gemivnet/IRL2FA/docs/images/pcb/pcb-iso.png

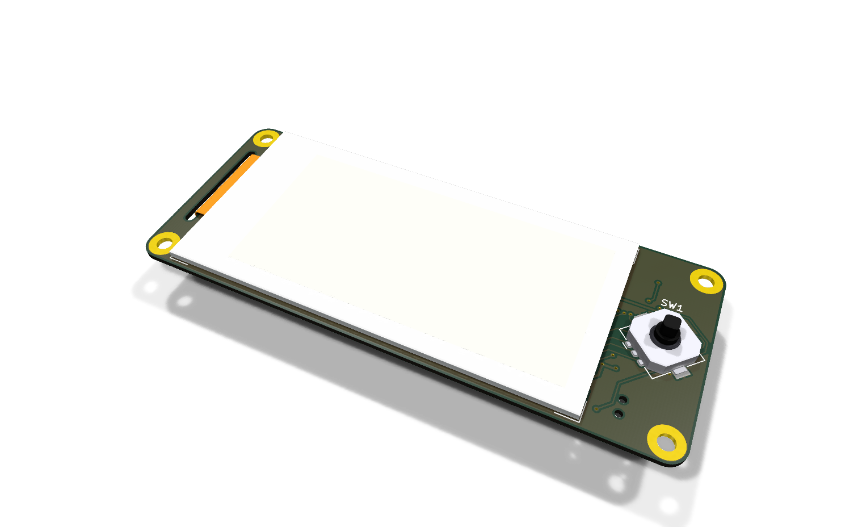
docs/images/pcb/pcb-iso.png
