gemivnet/IRL2FA/docs/images/screens/contacts.png

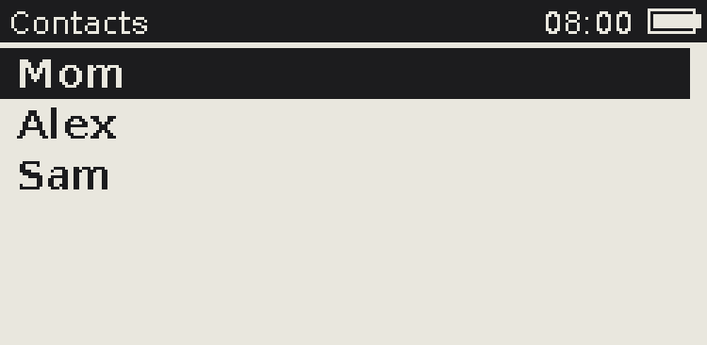
docs/images/screens/contacts.png
