gemivnet/IRL2FA/docs/images/sim/sim-battery.png

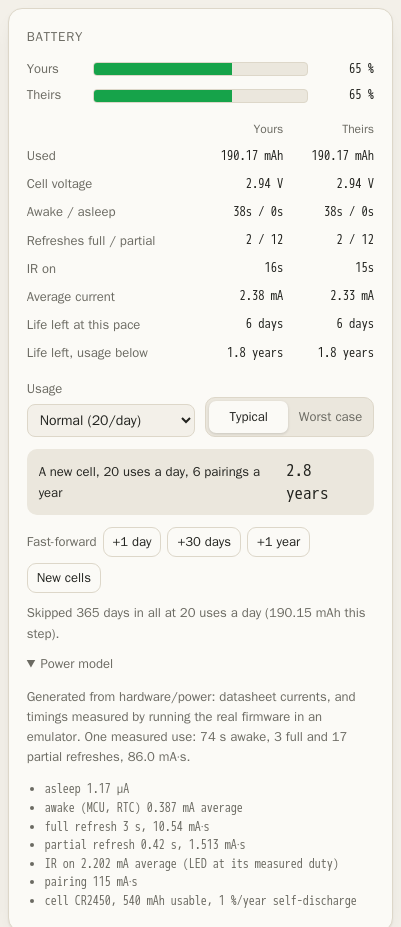
docs/images/sim/sim-battery.png
