gemivnet/IRL2FA/docs/images/sim/sim-mobile.png

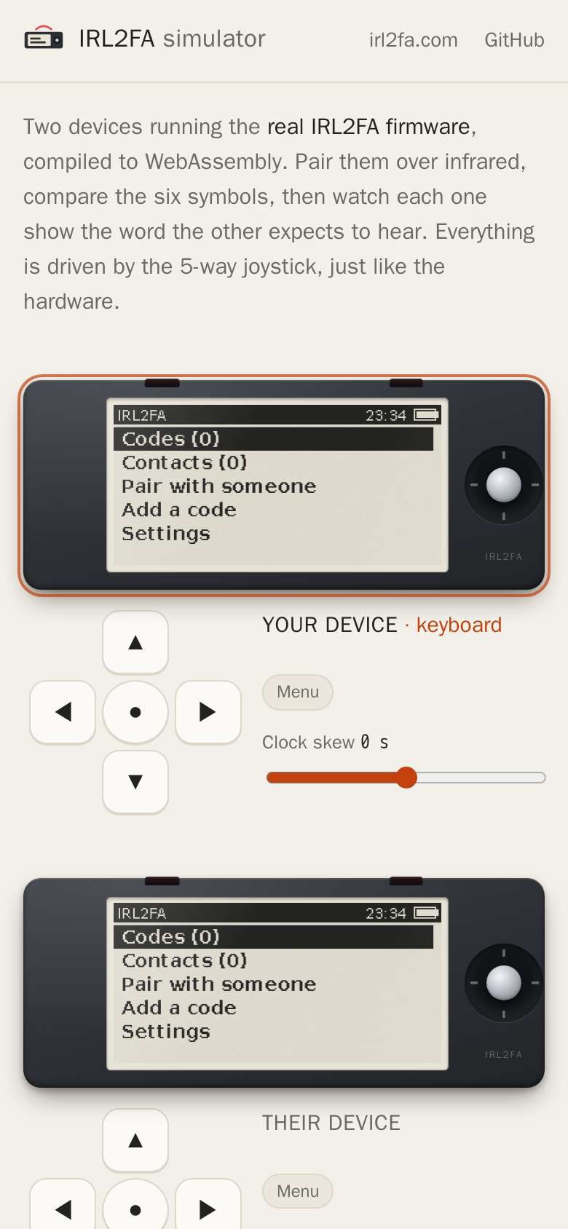
docs/images/sim/sim-mobile.png
