gemivnet/IRL2FA/docs/images/sim/sim-range.png

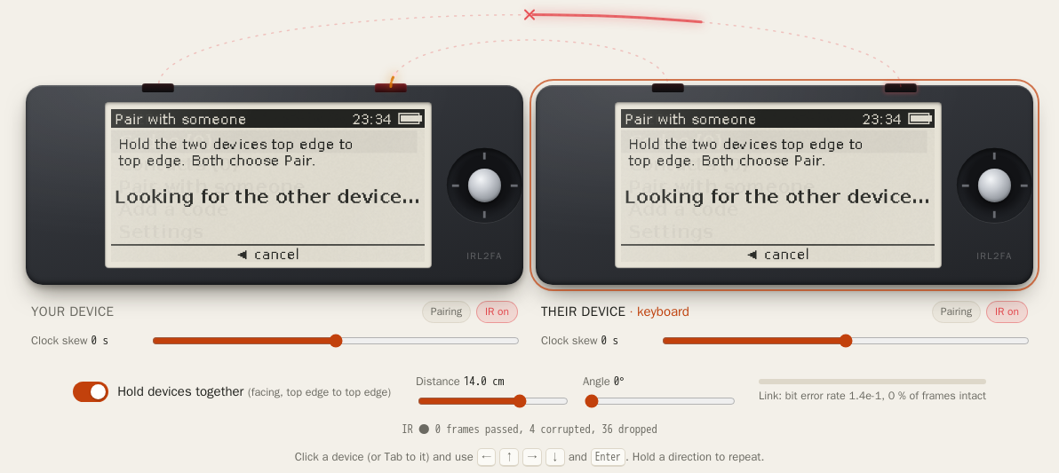
docs/images/sim/sim-range.png
