gemivnet/IRL2FA/docs/images/sim/sim-words.png

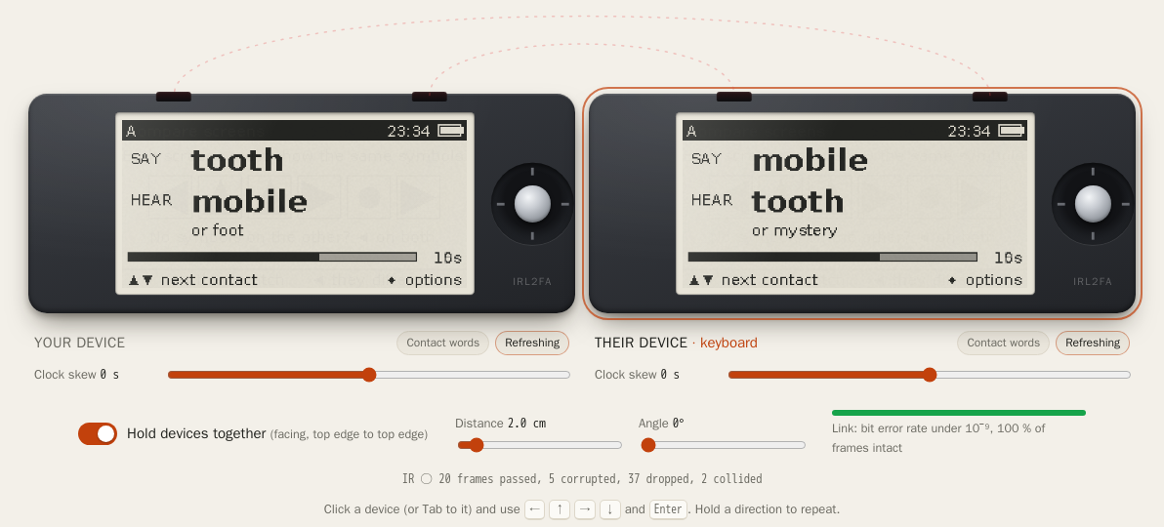
docs/images/sim/sim-words.png
