gemivnet/IRL2FA/hardware/fab/irl2fa-bom-jlcpcb.csv

Comment | Designator | Footprint | LCSC Part #
CR2450 | BT1 | BatteryHolder_MYOUNG_MY-2450-01_CR2450 | C964845
47u | C1,C2 | C_0805_2012Metric | C16780
100n | C3,C4,C8,C9 | C_0402_1005Metric | C1525
4.7u | C5 | C_0603_1608Metric | C19666
1u | C6 | C_0402_1005Metric | C52923
10n | C7 | C_0402_1005Metric | C15195
4.7u | C10,C11 | C_0805_2012Metric | C1779
1u | C12,C13,C14,C15,C16,C17,C18,C19 | C_0603_1608Metric | C15849
MBR0530 | D1,D2,D3 | D_SOD-123 | C77336
VSMB2948SL | D4 | LED_Vishay_VSMB2948SL_SideView | C6604342
FH34SRJ-24S | J1 | Hirose_FH34SRJ-24S-0.5SH_1x24-1MP_P0.50mm_Horizontal | C324726
47u | L1 | L_APV_ANR3015 | C7427088
AO3401A | Q1,Q2 | SOT-23 | C15127
NX3008NBK | Q3 | SOT-23 | C179399
AO3400A | Q4 | SOT-23 | C20917
VEMT2023SLX01 | Q5 | PhotoTransistor_Vishay_VEMT2023SLX01_SideView | C2843576
10k | R1,R2,R10 | R_0402_1005Metric | C25744
4.7k | R3,R4 | R_0402_1005Metric | C25900
100k | R5,R9 | R_0402_1005Metric | C25741
1M | R6 | R_0402_1005Metric | C26083
2.2 | R7 | R_0402_1005Metric | C25101
68 | R8 | R_0402_1005Metric | C25131
SKRHABE010 | SW1 | SW_Nav_Alps_SKRHABE010 | C139794
STM32U083KCU6 | U1 | UFQFPN-32-1EP_5x5mm_P0.5mm_EP3.5x3.5mm | C22459164
RV-3032-C7 | U2 | MicroCrystal_C7_SON-8_1.5x3.2mm_P0.9mm | C5127802
