gemivnet/IRL2FA/case/3mf/irl2fa-all.3mf

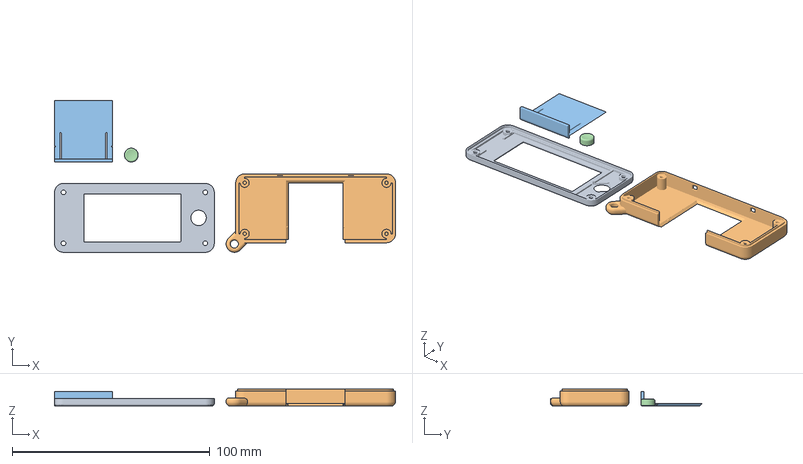
[picture p36: CAD file, 2026-10-29]
case/3mf/irl2fa-all.3mf
172.6 x 76.8 x 8.40 mm
irl2fa-front
irl2fa-back
irl2fa-door
irl2fa-cap
