gemivnet/IRL2FA/case/stl/irl2fa-front.stl

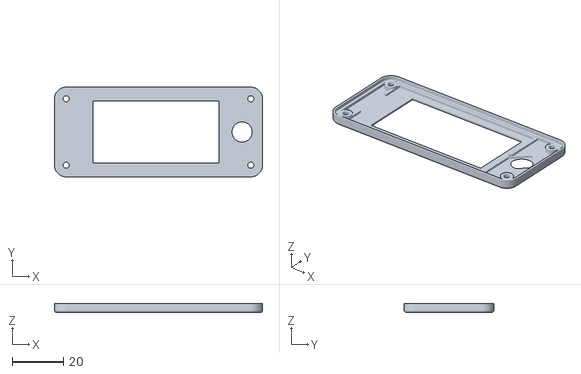
[picture p37: CAD file, 2026-10-29]
case/stl/irl2fa-front.stl
80.9 x 34.9 x 3.60
