gemivnet/IRL2FA/hardware/fab/irl2fa.step

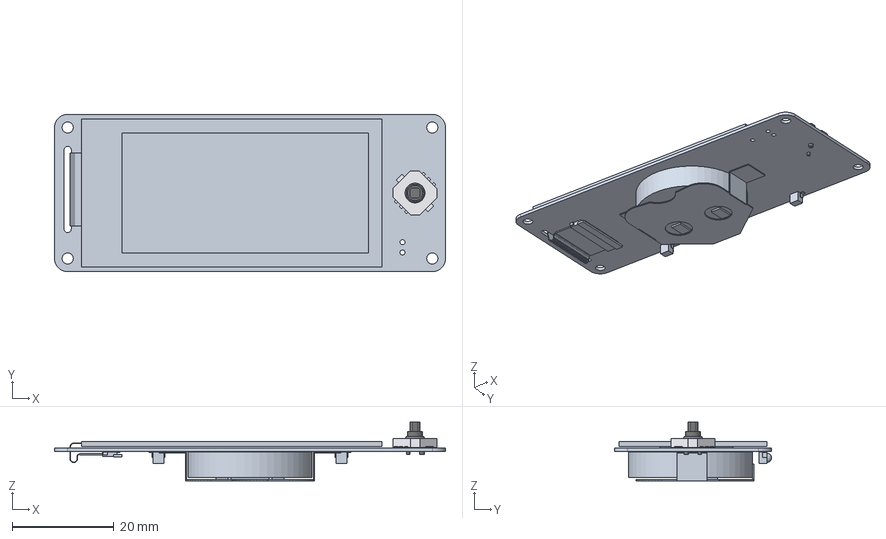
[picture p38: CAD file, 2026-10-30]
hardware/fab/irl2fa.step
77.0 x 31.0 x 11.6 mm
SW_Nav_Alps_SKRHABE010_0
SW_Nav_Alps_SKRHABE010_1
SW_Nav_Alps_SKRHABE010_2
SW_Nav_Alps_SKRHABE010_3
SW_Nav_Alps_SKRHABE010_4
SW_Nav_Alps_SKRHABE010_5
SW_Nav_Alps_SKRHABE010_6
SW_Nav_Alps_SKRHABE010_7
SW_Nav_Alps_SKRHABE010_8
SW_Nav_Alps_SKRHABE010_9
SW_Nav_Alps_SKRHABE010_10
SW_Nav_Alps_SKRHABE010_11
SW_Nav_Alps_SKRHABE010_12
SW_Nav_Alps_SKRHABE010_13
EPD_GoodDisplay_GDEY0213B74_Outline_0
EPD_GoodDisplay_GDEY0213B74_Outline_1
EPD_GoodDisplay_GDEY0213B74_Outline_2
Hirose_FH34SRJ-24S-0.5SH_1x24-1MP_P0.50mm_Horizontal_0
Hirose_FH34SRJ-24S-0.5SH_1x24-1MP_P0.50mm_Horizontal_1
Hirose_FH34SRJ-24S-0.5SH_1x24-1MP_P0.50mm_Horizontal_2
Hirose_FH34SRJ-24S-0.5SH_1x24-1MP_P0.50mm_Horizontal_3
Hirose_FH34SRJ-24S-0.5SH_1x24-1MP_P0.50mm_Horizontal_4
Hirose_FH34SRJ-24S-0.5SH_1x24-1MP_P0.50mm_Horizontal_5
Hirose_FH34SRJ-24S-0.5SH_1x24-1MP_P0.50mm_Horizontal_6
Hirose_FH34SRJ-24S-0.5SH_1x24-1MP_P0.50mm_Horizontal_7
Hirose_FH34SRJ-24S-0.5SH_1x24-1MP_P0.50mm_Horizontal_8
Hirose_FH34SRJ-24S-0.5SH_1x24-1MP_P0.50mm_Horizontal_9
Hirose_FH34SRJ-24S-0.5SH_1x24-1MP_P0.50mm_Horizontal_10
Hirose_FH34SRJ-24S-0.5SH_1x24-1MP_P0.50mm_Horizontal_11
Hirose_FH34SRJ-24S-0.5SH_1x24-1MP_P0.50mm_Horizontal_12
Hirose_FH34SRJ-24S-0.5SH_1x24-1MP_P0.50mm_Horizontal_13
Hirose_FH34SRJ-24S-0.5SH_1x24-1MP_P0.50mm_Horizontal_14
Hirose_FH34SRJ-24S-0.5SH_1x24-1MP_P0.50mm_Horizontal_15
Hirose_FH34SRJ-24S-0.5SH_1x24-1MP_P0.50mm_Horizontal_16
Hirose_FH34SRJ-24S-0.5SH_1x24-1MP_P0.50mm_Horizontal_17
Hirose_FH34SRJ-24S-0.5SH_1x24-1MP_P0.50mm_Horizontal_18
Hirose_FH34SRJ-24S-0.5SH_1x24-1MP_P0.50mm_Horizontal_19
Hirose_FH34SRJ-24S-0.5SH_1x24-1MP_P0.50mm_Horizontal_20
Hirose_FH34SRJ-24S-0.5SH_1x24-1MP_P0.50mm_Horizontal_21
Hirose_FH34SRJ-24S-0.5SH_1x24-1MP_P0.50mm_Horizontal_22
Hirose_FH34SRJ-24S-0.5SH_1x24-1MP_P0.50mm_Horizontal_23
Hirose_FH34SRJ-24S-0.5SH_1x24-1MP_P0.50mm_Horizontal_24
Hirose_FH34SRJ-24S-0.5SH_1x24-1MP_P0.50mm_Horizontal_25
Hirose_FH34SRJ-24S-0.5SH_1x24-1MP_P0.50mm_Horizontal_26
Hirose_FH34SRJ-24S-0.5SH_1x24-1MP_P0.50mm_Horizontal_27
PhotoTransistor_Vishay_VEMT2023SLX01_SideView_0
PhotoTransistor_Vishay_VEMT2023SLX01_SideView_1
PhotoTransistor_Vishay_VEMT2023SLX01_SideView_2
PhotoTransistor_Vishay_VEMT2023SLX01_SideView_3
PhotoTransistor_Vishay_VEMT2023SLX01_SideView_4
PhotoTransistor_Vishay_VEMT2023SLX01_SideView_5
BatteryHolder_MYOUNG_MY-2450-01_CR2450_0
BatteryHolder_MYOUNG_MY-2450-01_CR2450_1
BatteryHolder_MYOUNG_MY-2450-01_CR2450_2
BatteryHolder_MYOUNG_MY-2450-01_CR2450_3
BatteryHolder_MYOUNG_MY-2450-01_CR2450_4
BatteryHolder_MYOUNG_MY-2450-01_CR2450_5
BatteryHolder_MYOUNG_MY-2450-01_CR2450_6
BatteryHolder_MYOUNG_MY-2450-01_CR2450_7
BatteryHolder_MYOUNG_MY-2450-01_CR2450_8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
