gemivnet/IRL2FA/case/stl/irl2fa-door.stl

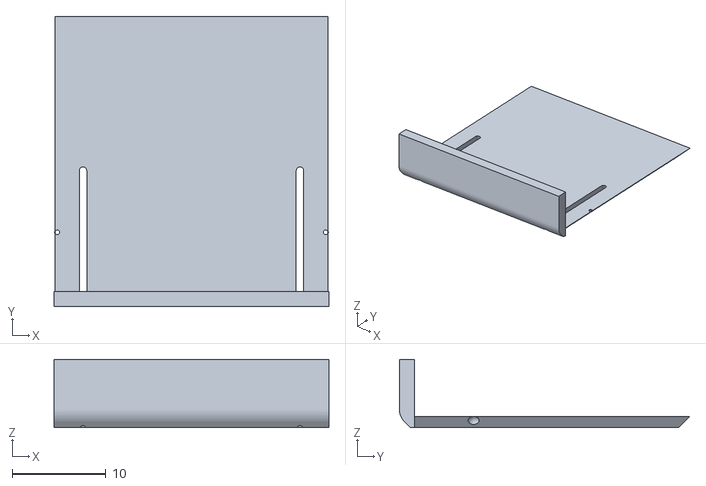
[picture p39: CAD file, 2026-10-29]
case/stl/irl2fa-door.stl
29.4 x 31.0 x 7.30
