gemivnet/IRL2FA/case/stl/irl2fa-cap.stl

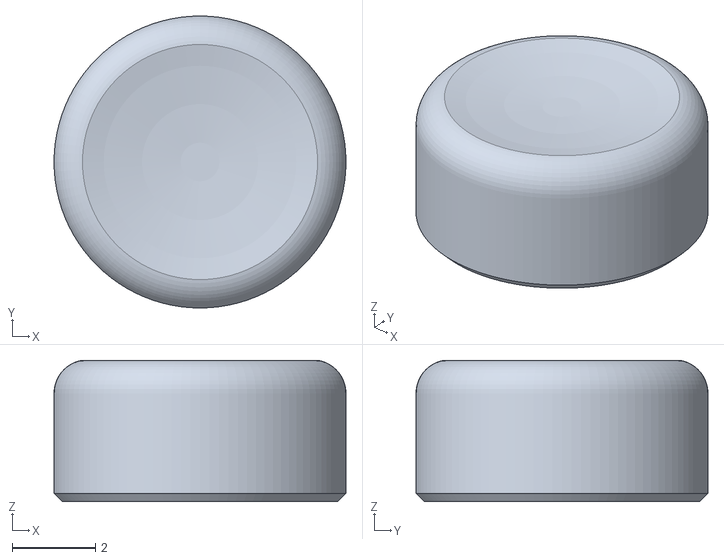
[picture p40: CAD file, 2026-10-29]
case/stl/irl2fa-cap.stl
7.00 x 7.00 x 3.39
