gemivnet/IRL2FA/case/stl/irl2fa-back.stl

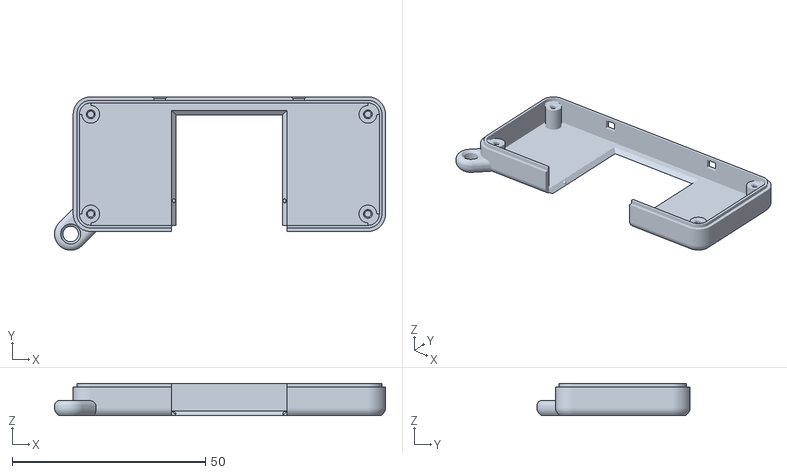
[picture p41: CAD file, 2026-10-29]
case/stl/irl2fa-back.stl
85.7 x 39.7 x 8.40
