gemivnet/IRL2FA/case/board_dims.scad

// GENERATED FILE - DO NOT EDIT.
// Source: hardware/board.yaml  (regenerate: python case/tools/gen_dims.py)
// Units: mm. Board coordinates: origin at the board's top-left corner seen
// from the FRONT, x right, y down (see board.yaml).
// SPDX-License-Identifier: CC-BY-SA-4.0

board_width = 77;
board_height = 31;
board_thickness = 0.8;
board_corner_radius = 2.6;
board_mounting_holes = [[2.6, 2.6], [74.4, 2.6], [2.6, 28.4], [74.4, 28.4]];  // each [x, y]
board_mounting_hole_drill = 2.2;
display_part = "GDEY0213B74";
display_glass = [5.3, 0.9, 59.2, 29.2, 1];  // [x, y, w, h, t]
display_glass_x = 5.3;
display_glass_y = 0.9;
display_glass_w = 59.2;
display_glass_h = 29.2;
display_glass_t = 1;
display_active = [13.25, 3.65, 48.55, 23.7];  // [x, y, w, h]
display_active_x = 13.25;
display_active_y = 3.65;
display_active_w = 48.55;
display_active_h = 23.7;
display_fpc_exit = "left";
display_fpc_width = 12.5;
display_fpc_length = 14.3;
display_adhesive = 0.2;
fpc_slot = [1.9, 6.3, 1.4, 17];  // [x, y, w, h]
fpc_slot_x = 1.9;
fpc_slot_y = 6.3;
fpc_slot_w = 1.4;
fpc_slot_h = 17;
joystick_part = "SKRHABE010";
joystick_x = 71;
joystick_y = 15.5;
joystick_body = 7.5;
joystick_body_height = 1.8;
joystick_shoulder_diameter = 3;
joystick_stem_square = 1.95;
joystick_stem_corner_r = 0.5;
joystick_stem_fit_max = 1.7;
joystick_stem_top = 5;
ir_emitter = [56.5, 1.37];  // [x, y]
ir_emitter_x = 56.5;
ir_emitter_y = 1.37;
ir_detector = [20.5, 1.37];  // [x, y]
ir_detector_x = 20.5;
ir_detector_y = 1.37;
battery_part = "MY-2450-01";
battery_x = 38.5;
battery_y = 16;
battery_cell_diameter = 24.5;
battery_cell_thickness = 5;
battery_holder_height = 5.7;
back_keepout_height = 5.8;
