gemivnet/IRL2FA/hardware/fab/irl2fa-schematic.pdf

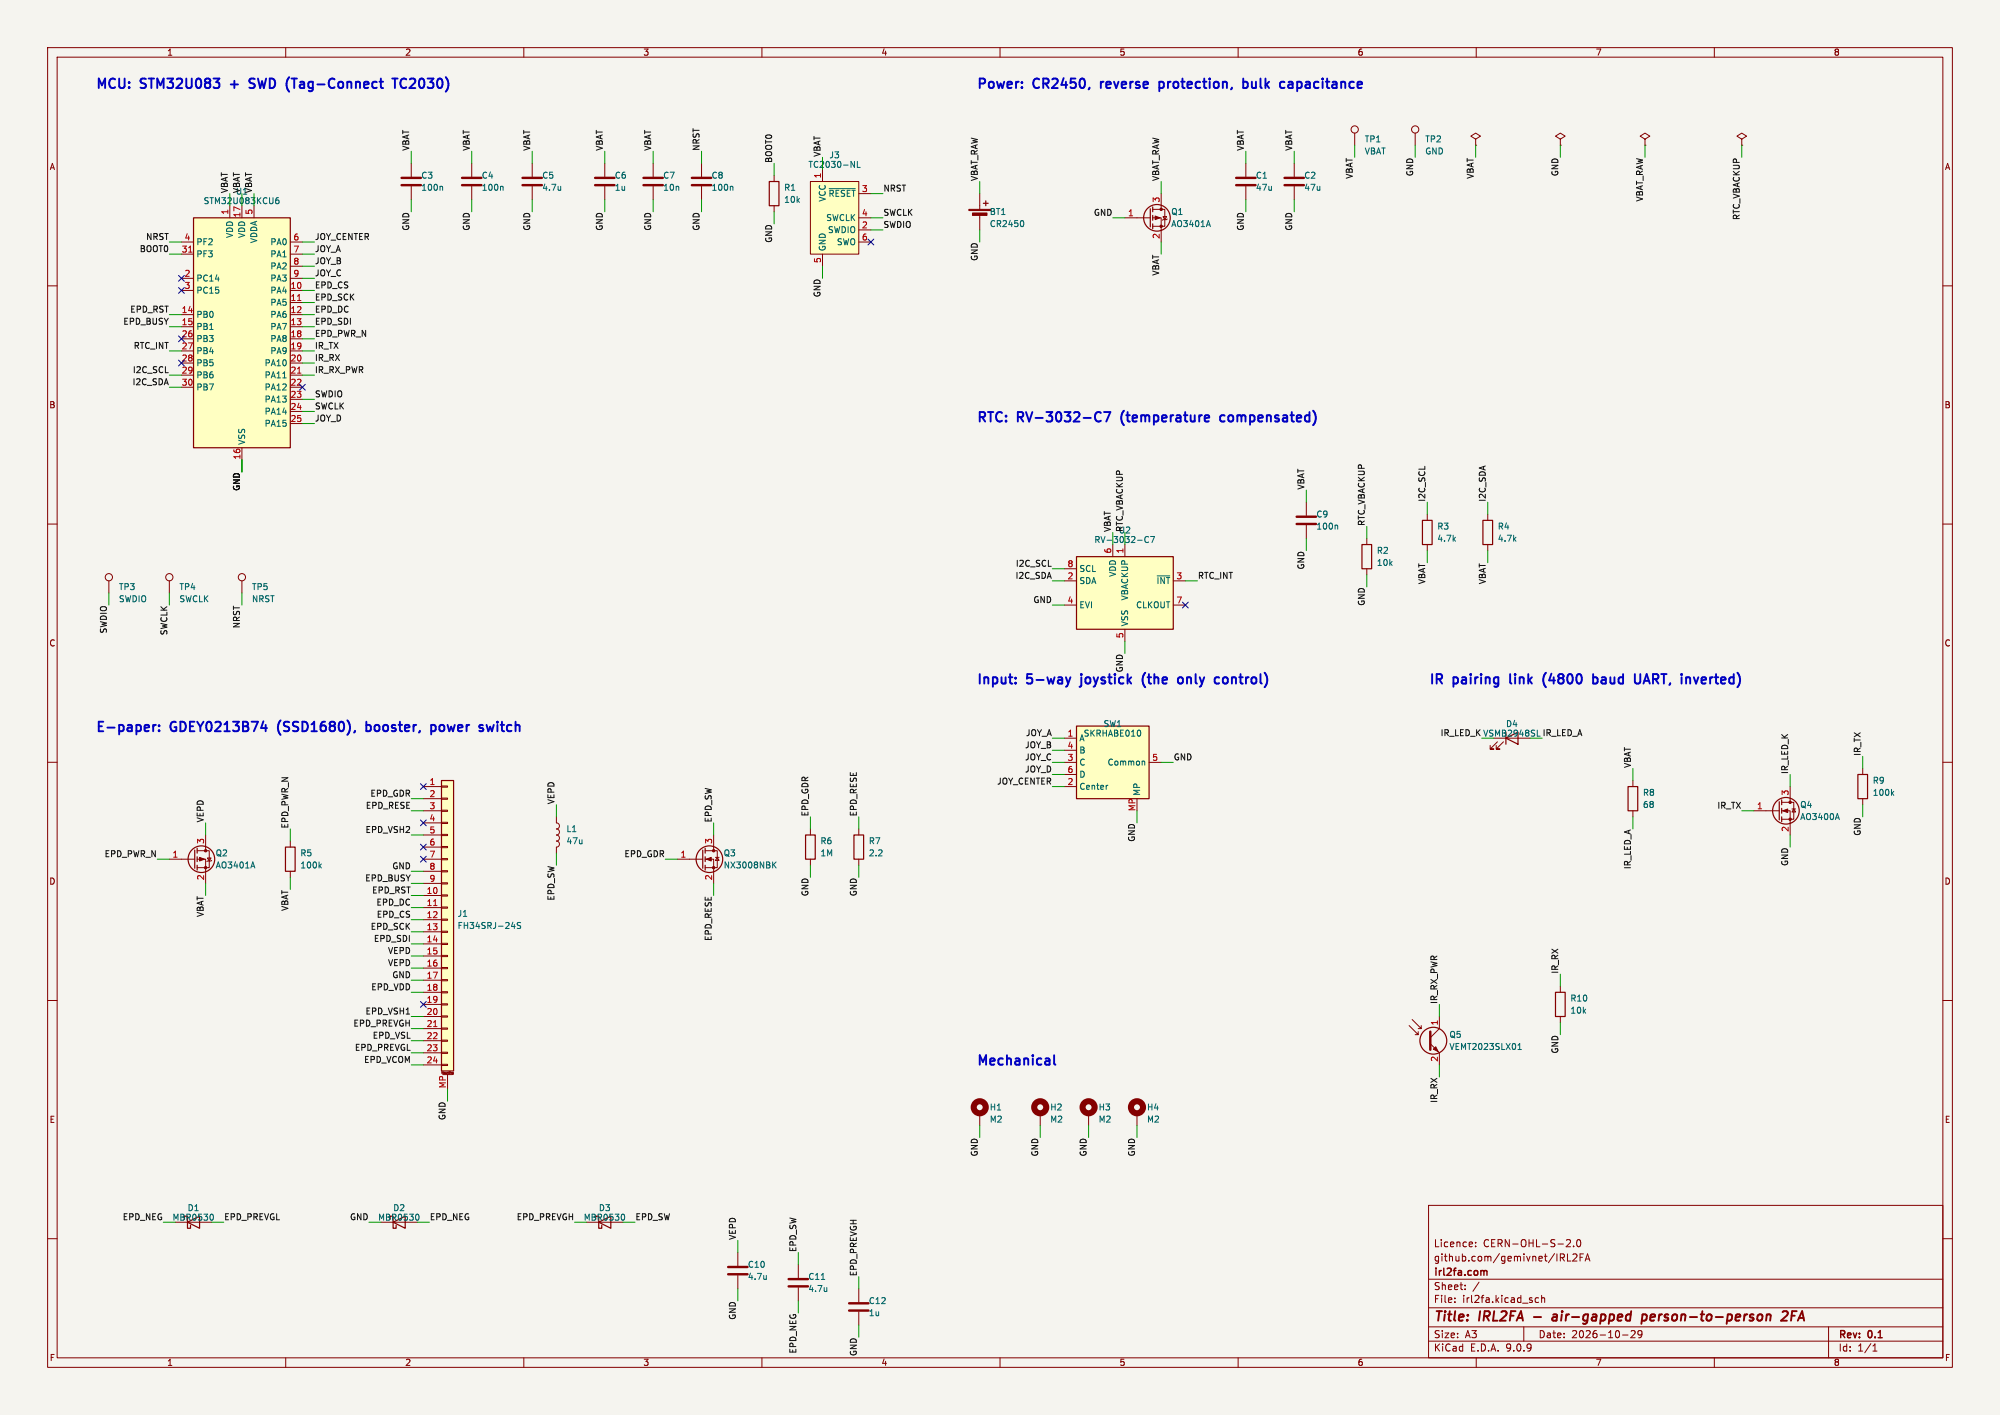
[picture p42: page 1]

5 ~{RESET}3 SWCLK 4 SWDIO 2 SWO 6
