gemivnet/IRL2FA/hardware/irl2fa.kicad_pcb

## KiCad design hardware/irl2fa.kicad_pcb (2026-10-30)

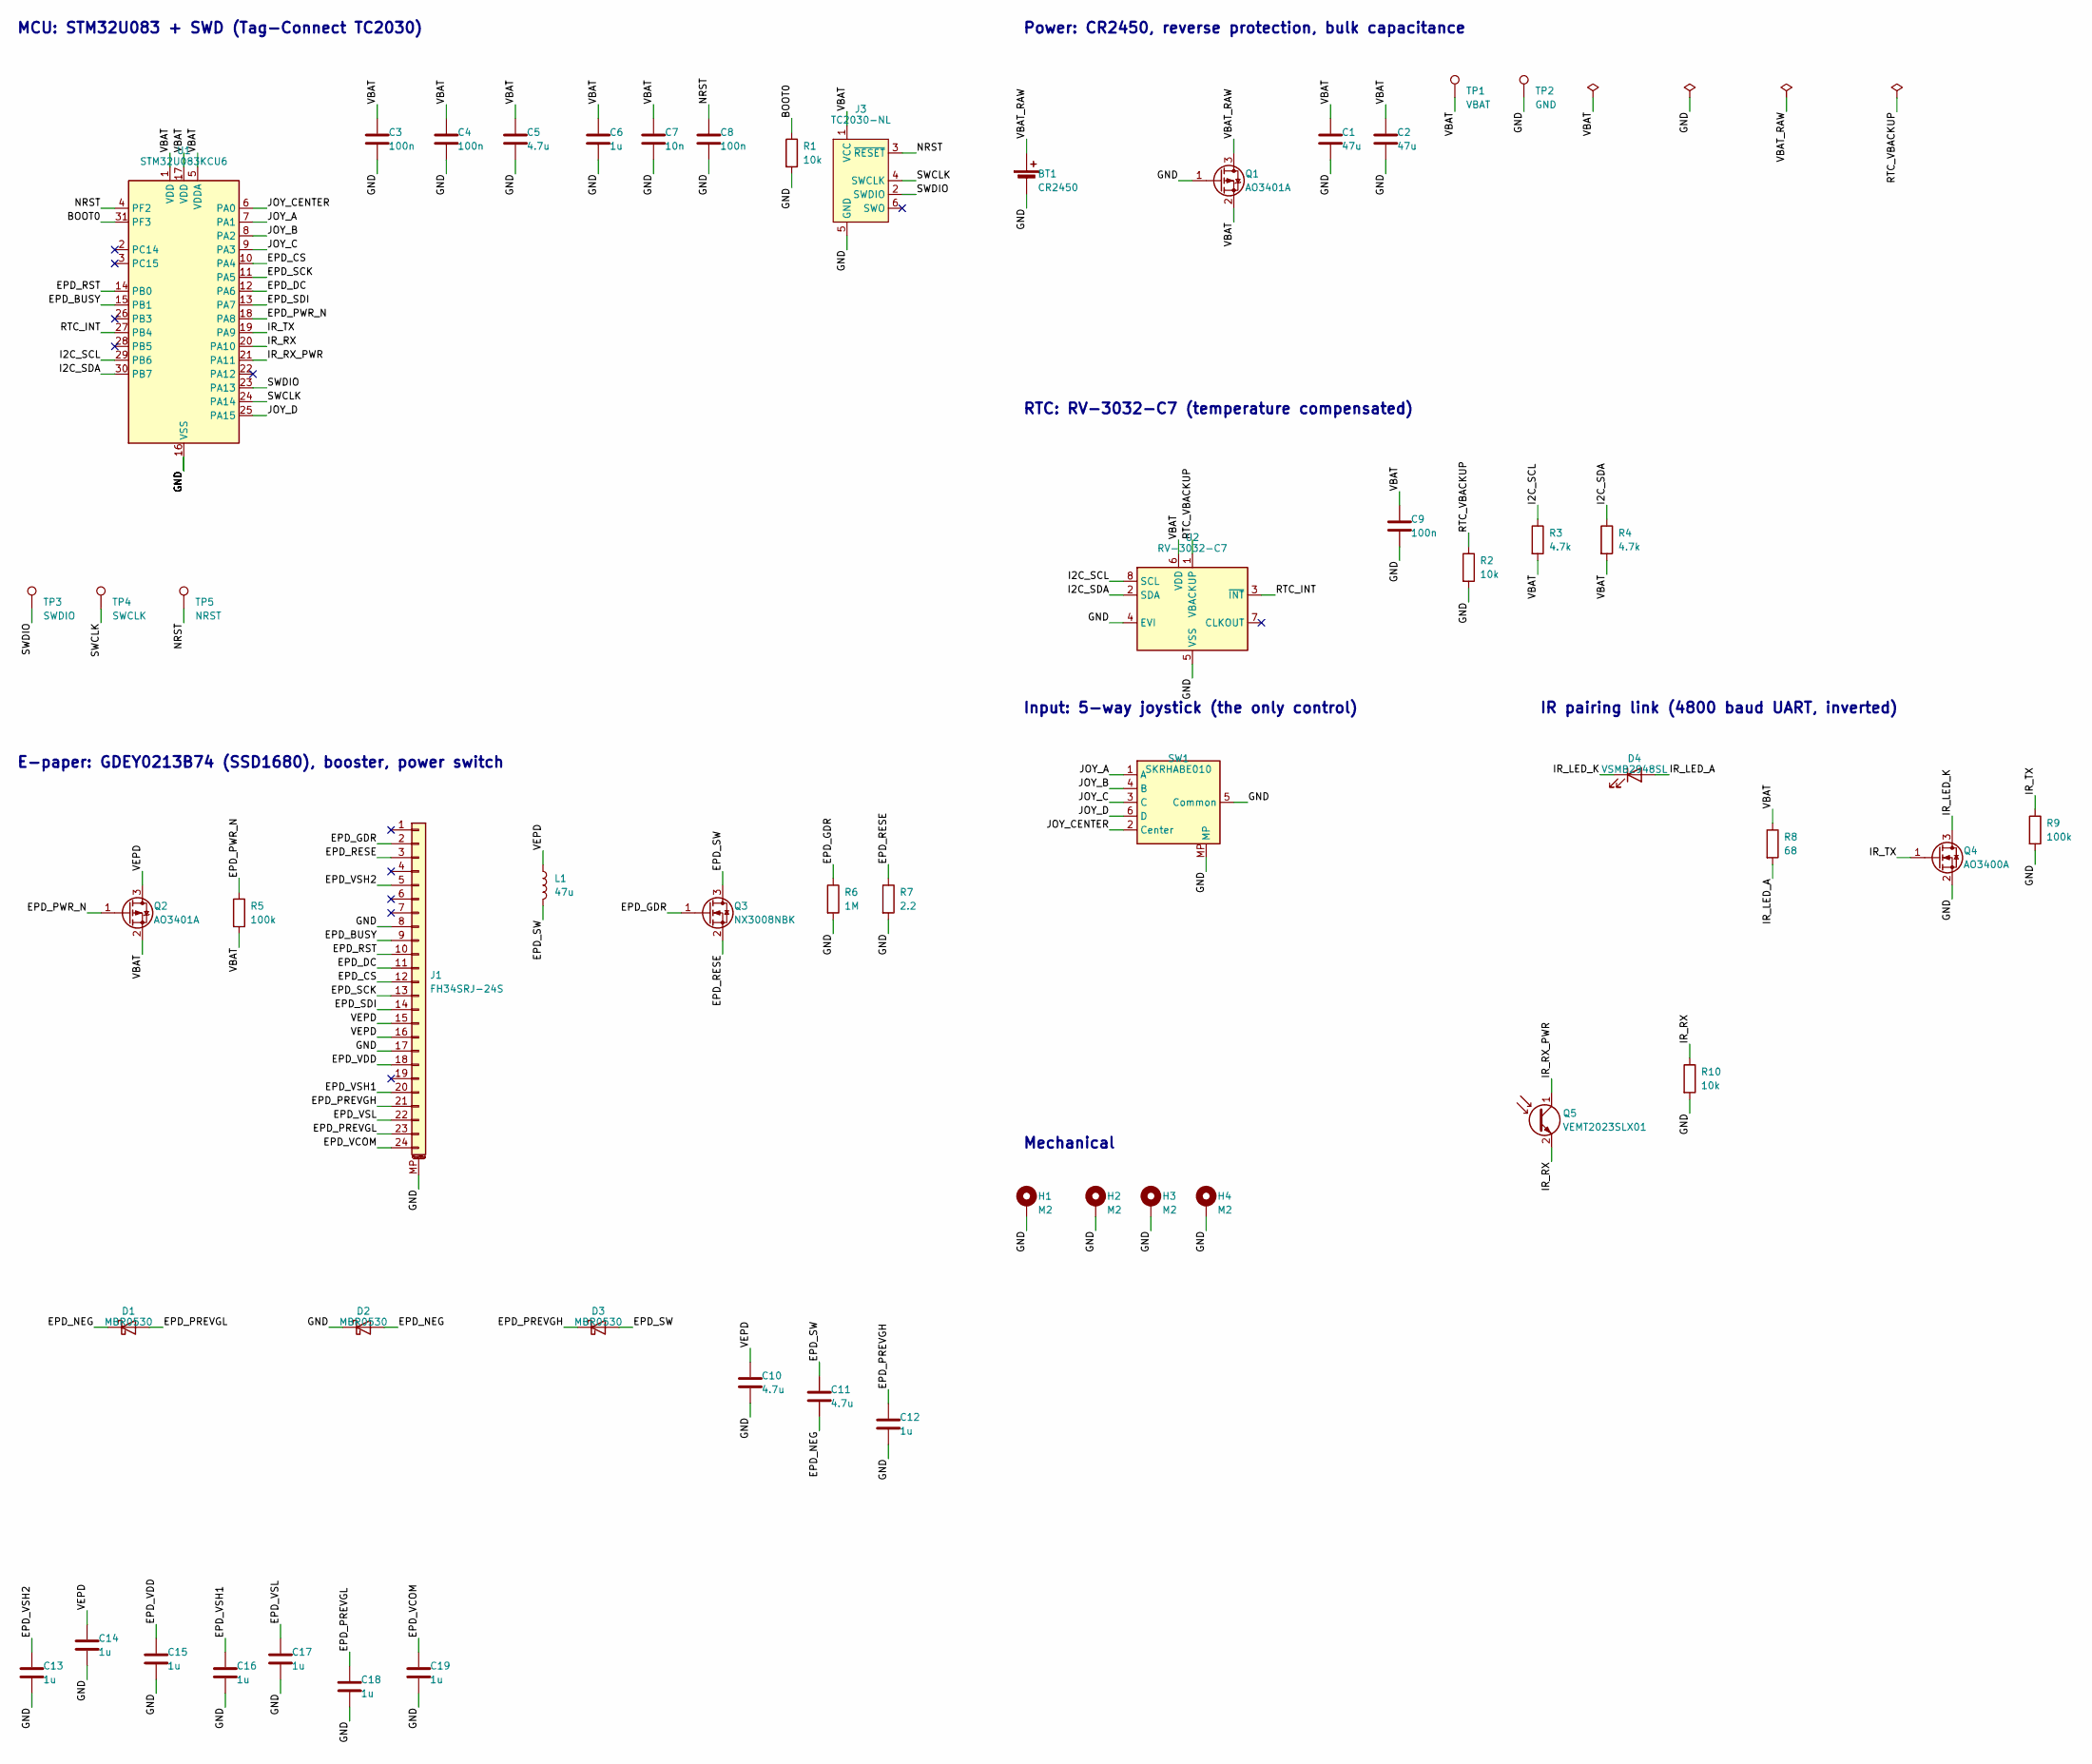
[picture p43: schematic irl2fa.kicad_sch, IRL2FA - air-gapped person-to-person 2FA]

Parts:
BT1: CR2450; BatteryHolder_MYOUNG_MY-2450-01_CR2450; MPN MY-2450-01; LCSC C964845
C1, C2: 47u; C_0805_2012Metric; MPN CL21A476MQYNNNE; LCSC C16780
C3, C4, C8, C9: 100n; C_0402_1005Metric; MPN CL05B104KO5NNNC; LCSC C1525
C5: 4.7u; C_0603_1608Metric; MPN CL10A475KO8NNNC; LCSC C19666
C6: 1u; C_0402_1005Metric; MPN CL05A105KA5NQNC; LCSC C52923
C7: 10n; C_0402_1005Metric; MPN CL05B103KB5NNNC; LCSC C15195
C10, C11: 4.7u; C_0805_2012Metric; MPN CL21A475KAQNNNE; LCSC C1779
C12, C13, C14, C15, C16, C17, C18, C19: 1u; C_0603_1608Metric; MPN CL10A105KB8NNNC; LCSC C15849
D1, D2, D3: MBR0530; D_SOD-123; MPN MBR0530; LCSC C77336
D4: VSMB2948SL; LED_Vishay_VSMB2948SL_SideView; MPN VSMB2948SL; LCSC C6604342
H1, H2, H3, H4: M2; MountingHole_2.2mm_M2_Pad
J1: FH34SRJ-24S; Hirose_FH34SRJ-24S-0.5SH_1x24-1MP_P0.50mm_Horizontal; MPN FH34SRJ-24S-0.5SH(50); LCSC C324726
J3: TC2030-NL; Tag-Connect_TC2030-IDC-NL_2x03_P1.27mm_Vertical
L1: 47u; L_APV_ANR3015; MPN ANR3015T470M; LCSC C7427088
Q1, Q2: AO3401A; SOT-23; MPN AO3401A; LCSC C15127
Q3: NX3008NBK; SOT-23; MPN NX3008NBK,215; LCSC C179399
Q4: AO3400A; SOT-23; MPN AO3400A; LCSC C20917
Q5: VEMT2023SLX01; PhotoTransistor_Vishay_VEMT2023SLX01_SideView; MPN VEMT2023SLX01; LCSC C2843576
R1, R2, R10: 10k; R_0402_1005Metric; MPN 0402WGF1002TCE; LCSC C25744
R3, R4: 4.7k; R_0402_1005Metric; MPN 0402WGF4701TCE; LCSC C25900
R5, R9: 100k; R_0402_1005Metric; MPN 0402WGF1003TCE; LCSC C25741
R6: 1M; R_0402_1005Metric; MPN 0402WGF1004TCE; LCSC C26083
R7: 2.2; R_0402_1005Metric; MPN 0402WGF220KTCE; LCSC C25101
R8: 68; R_0402_1005Metric; MPN 0402WGF680JTCE; LCSC C25131
SW1: SKRHABE010; SW_Nav_Alps_SKRHABE010; MPN SKRHABE010; LCSC C139794
TP1: VBAT; TestPoint_Pad_D1.5mm
TP2: GND; TestPoint_Pad_D1.5mm
TP3: SWDIO; TestPoint_Pad_D1.5mm
TP4: SWCLK; TestPoint_Pad_D1.5mm
TP5: NRST; TestPoint_Pad_D1.5mm
U1: STM32U083KCU6; UFQFPN-32-1EP_5x5mm_P0.5mm_EP3.5x3.5mm; MPN STM32U083KCU6; LCSC C22459164
U2: RV-3032-C7; MicroCrystal_C7_SON-8_1.5x3.2mm_P0.9mm; MPN RV-3032-C7 32.768kHz 2.5ppm-TA-QC; LCSC C5127802

Connections:
/BOOT0: R1.1, U1.31 (PF3)
/EPD_BUSY: J1.9, U1.15 (PB1)
/EPD_CS: J1.12, U1.10 (PA4)
/EPD_DC: J1.11, U1.12 (PA6)
/EPD_GDR: J1.2, Q3.1 (G), R6.1
/EPD_NEG: C11.2, D1.1 (K), D2.2 (A)
/EPD_PREVGH: C12.1, D3.1 (K), J1.21
/EPD_PREVGL: C18.1, D1.2 (A), J1.23
/EPD_PWR_N: Q2.1 (G), R5.1, U1.18 (PA8)
/EPD_RESE: J1.3, Q3.2 (S), R7.1
/EPD_RST: J1.10, U1.14 (PB0)
/EPD_SCK: J1.13, U1.11 (PA5)
/EPD_SDI: J1.14, U1.13 (PA7)
/EPD_SW: C11.1, D3.2 (A), L1.2, Q3.3 (D)
/EPD_VCOM: C19.1, J1.24
/EPD_VDD: C15.1, J1.18
/EPD_VSH1: C16.1, J1.20
/EPD_VSH2: C13.1, J1.5
/EPD_VSL: C17.1, J1.22
/GND: BT1.2 (-), C1.2, C2.2, C3.2, C4.2, C5.2, C6.2, C7.2, C8.2, C9.2, C10.2, C12.2, C13.2, C14.2, C15.2, C16.2, C17.2, C18.2, C19.2, D2.1 (K), H1.1, H2.1, H3.1, H4.1, J1.8, J1.17, J1.MP (MountPin), J3.5 (GND), Q1.1 (G), Q4.2 (S), R1.2, R2.2, R6.2, R7.2, R9.2, R10.2, SW1.5 (Common), SW1.MP, TP2.1, U1.16 (VSS), U1.32 (VSS), U1.33 (VSS), U2.4 (EVI), U2.5 (VSS)
/I2C_SCL: R3.1, U1.29 (PB6), U2.8 (SCL)
/I2C_SDA: R4.1, U1.30 (PB7), U2.2 (SDA)
/IR_LED_A: D4.2 (A), R8.2
/IR_LED_K: D4.1 (K), Q4.3 (D)
/IR_RX: Q5.2 (E), R10.1, U1.20 (PA10)
/IR_RX_PWR: Q5.1 (C), U1.21 (PA11)
/IR_TX: Q4.1 (G), R9.1, U1.19 (PA9)
/JOY_A: SW1.1 (A), U1.7 (PA1)
/JOY_B: SW1.4 (B), U1.8 (PA2)
/JOY_C: SW1.3 (C), U1.9 (PA3)
/JOY_CENTER: SW1.2 (Center), U1.6 (PA0)
/JOY_D: SW1.6 (D), U1.25 (PA15)
/NRST: C8.1, J3.3 (~RESET), TP5.1, U1.4 (PF2)
/RTC_INT: U1.27 (PB4), U2.3 (~INT)
/RTC_VBACKUP: R2.1, U2.1 (VBACKUP)
/SWCLK: J3.4 (SWCLK), TP4.1, U1.24 (PA14)
/SWDIO: J3.2 (SWDIO), TP3.1, U1.23 (PA13)
/VBAT: C1.1, C2.1, C3.1, C4.1, C5.1, C6.1, C7.1, C9.1, J3.1 (VCC), Q1.2 (S), Q2.2 (S), R3.2, R4.2, R5.2, R8.1, TP1.1, U1.1 (VDD), U1.5 (VDDA), U1.17 (VDD), U2.6 (VDD)
/VBAT_RAW: BT1.1 (+), Q1.3 (D)
/VEPD: C10.1, C14.1, J1.15, J1.16, L1.1, Q2.3 (D)

Notes on the sheet:
Power: CR2450, reverse protection, bulk capacitance
MCU: STM32U083 + SWD (Tag-Connect TC2030)
RTC: RV-3032-C7 (temperature compensated)
Input: 5-way joystick (the only control)
E-paper: GDEY0213B74 (SSD1680), booster, power switch
IR pairing link (4800 baud UART, inverted)
Mechanical

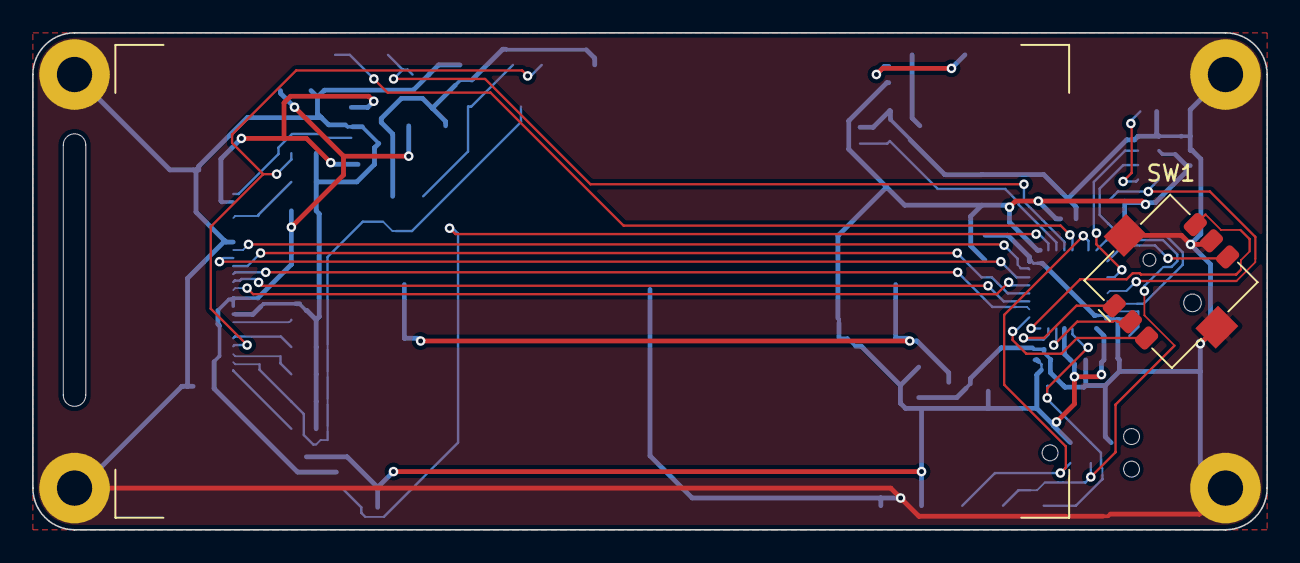
[picture p44: board irl2fa.kicad_pcb from above]

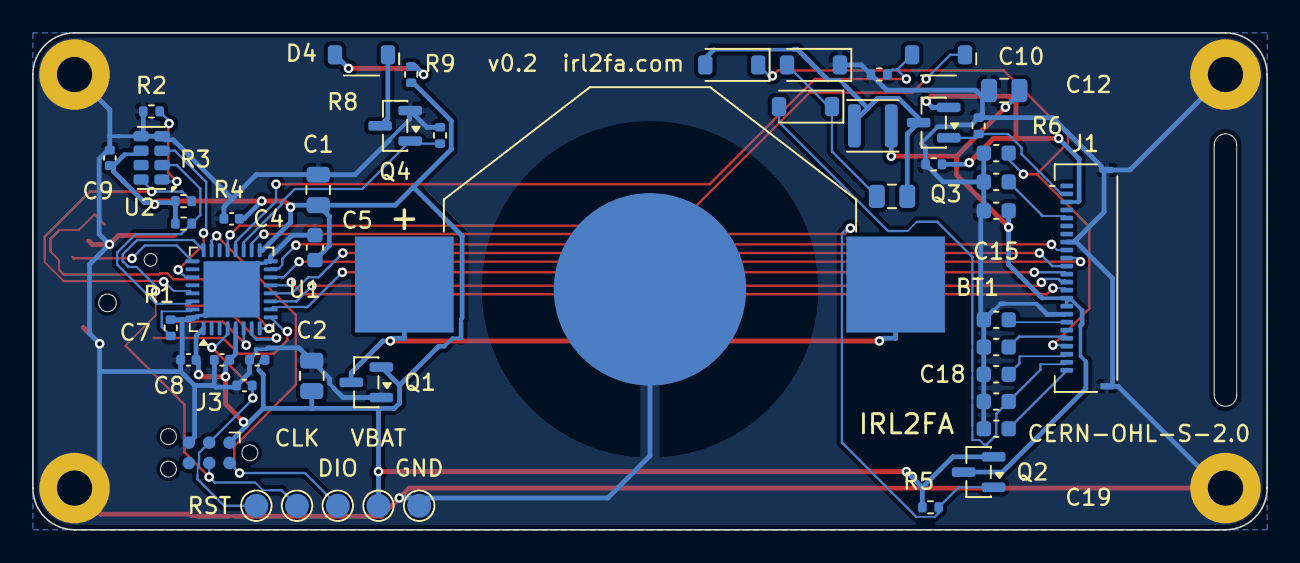
[picture p45: board irl2fa.kicad_pcb from below]

Board: 2 copper layers, 77.0 x 31.0 mm, 55 parts (49 on the bottom side), 40 nets.

Other parts of the board:
DS1: GDEY0213B74; EPD_GoodDisplay_GDEY0213B74_Outline
