gemivnet/IRL2FA/hardware/tools/gen_schematic.py

#!/usr/bin/env python3
"""Bootstrap hardware/irl2fa.kicad_sch from tools/design.py.

Every pin gets a short wire stub and a net label (or a no-connect flag), and
parts are grouped into titled blocks. Symbols are embedded from the KiCad
stock libraries (CC-BY-SA-4.0 with the KiCad libraries exception) and from
hardware/lib/irl2fa.kicad_sym.

Run inside the KiCad 9 container so the stock libraries are available:
    docker run --rm -v "$PWD":/w -w /w kicad/kicad:9.0 \
        python3 hardware/tools/gen_schematic.py

SPDX-License-Identifier: CERN-OHL-S-2.0
"""
import copy
import math
import os
import sys
import uuid
from pathlib import Path

sys.path.insert(0, str(Path(__file__).resolve().parent))
from sexpr import Q, dump, find, find_all, parse  # noqa: E402

import design  # noqa: E402

HW = Path(__file__).resolve().parents[1]
STOCK = Path(os.environ.get("KICAD_SYMBOL_DIR", "/usr/share/kicad/symbols"))
LOCAL = {"irl2fa": HW / "lib" / "irl2fa.kicad_sym"}
OUT = HW / "irl2fa.kicad_sch"
PROJECT = "irl2fa"
GRID = 2.54
STUB = 2.54

NS = uuid.UUID("6f1c7f3e-6d4b-4d61-9a0e-2a1b9b3c0f5a")


def uid(*parts):
    """Deterministic UUIDs keep regenerated files diff-friendly."""
    return Q(str(uuid.uuid5(NS, "/".join(str(p) for p in parts))))


ROOT = uid("root")

_lib_cache = {}


def load_lib(lib):
    if lib not in _lib_cache:
        path = LOCAL.get(lib, STOCK / f"{lib}.kicad_sym")
        tree = parse(path.read_text())
        _lib_cache[lib] = {s[1]: s for s in find_all(tree, "symbol")}
    return _lib_cache[lib]


def flatten(lib, name):
    """Returns the symbol with `extends` resolved, renamed to lib:name."""
    syms = load_lib(lib)
    sym = copy.deepcopy(syms[name])
    ext = find(sym, "extends")
    if ext:
        parent = flatten(lib, ext[1])
        pname = ext[1]
        body = [x for x in parent if not (isinstance(x, list) and x[0] == "property")]
        props = find_all(sym, "property")
        merged = [Q(f"{lib}:{name}")]
        for x in body[2:]:
            if isinstance(x, list) and x[0] == "symbol":
                x = copy.deepcopy(x)
                x[1] = Q(x[1].replace(pname, name, 1))
            merged.append(x)
        # properties go right after the flags, as KiCad writes them
        out = ["symbol", merged[0]]
        flags = [x for x in merged[1:] if not (isinstance(x, list) and x[0] == "symbol")]
        units = [x for x in merged[1:] if isinstance(x, list) and x[0] == "symbol"]
        return out + flags + props + units
    sym[1] = Q(f"{lib}:{name}")
    return sym


def pins_of(sym):
    """{number: (x, y, angle, name, type)} in symbol (y-up) coordinates."""
    out = {}

    def walk(node):
        for x in node:
            if isinstance(x, list) and x:
                if x[0] == "pin":
                    at = find(x, "at")
                    num = find(x, "number")[1]
                    name = find(x, "name")[1]
                    out[str(num)] = (float(at[1]), float(at[2]), float(at[3]) if len(at) > 3 else 0.0,
                                     name, x[1])
                else:
                    walk(x)

    walk(sym)
    return out


def snap(v):
    return round(v / GRID) * GRID


def fmt(v):
    return f"{v:.4f}".rstrip("0").rstrip(".")


def font(size=1.27, bold=False):
    f = ["font", ["size", fmt(size), fmt(size)]]
    if bold:
        f += [["thickness", fmt(size / 5)], ["bold", "yes"]]
    return f


def prop(name, value, x, y, hide=False, justify=None, angle=0):
    eff = ["effects", font()]
    if justify:
        eff.append(["justify", *justify])
    if hide:
        eff.append(["hide", "yes"])
    return ["property", Q(name), Q(value or ""), ["at", fmt(x), fmt(y), str(angle)], eff]
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
