gemivnet/IRL2FA/(commit log)

2026-04-11 Add new capacitor footprint and 3D model, update PCB layout and schematic
2026-07-12 Fix doc typos, correct pin/license references, add gitattributes and macOS ignores
    - README: fix "continuious"/"prefer not have" typos
    - pin-assignments: pin 12 is PB2/TOSC2, not duplicate PC2
    - LICENSE-LIBRARIES: point at actual library folders (models/footprints/symbols)
    - .gitignore: add macOS .DS_Store/._* entries
    - .gitattributes: normalize line endings (eol=lf) and mark .stp binary to stop CRLF churn
2026-10-29 Add portable firmware core with host tests
    TOTP (RFC 6238, SHA1/256/512), contact verification words, IR pairing
    (commit/reveal X25519 + SAS), encrypted power-fail-safe flash store with
    optional PIN, joystick-only UI, and a virtual board HAL shared by the tests
    and the upcoming browser simulator. Screen renders in docs/images/screens.
2026-10-29 Add hardware pin map, generators, SPICE benches, power model and docs
    - hardware/pins.yaml and board.yaml: single sources of truth for the MCU
    pinout and the mechanical contract shared with the case
    - schematic/PCB bootstrap generators (KiCad 9 + Freerouting in Docker)
    - ngspice benches for coin-cell sag, e-paper booster, load-switch inrush,
    reverse battery and IR drive, with pass/fail limits
    - power model: 5.0 years typical / 2.7 worst at 20 uses a day
    - hardware CI workflow, fab output generator with staleness check
    - docs: pairing protocol, UI flows, hardware options, research notes
2026-10-29 Treat STEP/STL/3MF and other binary assets as binary
2026-10-29 Add STM32U083 port, Renode emulation tests and browser simulator
    - firmware/port/stm32u0: HAL for the STM32U083 (SSD1680 e-paper,
    RV-3032 RTC, joystick EXTI, IR UART, flash store, TRNG, Stop 2);
    99 KB flash, 20.6 KB RAM
    - firmware/renode: STM32U083 platform with SSD1680/RV-3032 models;
    boots, navigates and pairs two emulated devices over a UART hub
    - sim/: the firmware core compiled to WebAssembly with two devices,
    IR link, time warp and a battery meter fed by hardware/power/model.json
    - custom footprints and 3D models drawn from datasheets (hardware/lib)
    - pins.h and docs/pin-assignments.md generated from hardware/pins.yaml
    - idle timeout 30 s and power model updated to match
    Co-Au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
2026-10-29 Add parametric 3D-printable case with fit tests
    Front/back shells, sliding battery door and joystick cap in OpenSCAD,
    driven by hardware/board.yaml; STL/3MF exports and renders; pytest
    checks for manifold parts, wall thickness, 0.3 mm clearance to every
    part and window/joystick/IR alignment.
2026-10-29 Add README, design docs, release workflow and simulator screenshots
    - README in the project's public style: how it works, simulator link,
    hardware summary, build-one guide, CI summary, licences
    - docs: design review, PCB design, hardware testing, release notes
    - root Makefile (make check), CONTRIBUTING, issue templates, kitspace.yaml
    - release workflow packaging firmware, fab files and case on tags
    - reproducible simulator screenshots (sim/tools/screenshots.sh)
    - interactive BOM and schematic published next to the simulator
2026-10-29 Add the routed IRL2FA v0.1 board: schematic, PCB, fab outputs and BOM
    - STM32U083, GDEY0213B74 e-paper with booster and power switch,
    RV-3032 RTC, Alps 5-way joystick, IR link, CR2450 holder
    - 80 x 34 mm, 2 layers, 1.0 mm; autorouted with Freerouting,
    ERC/DRC (with schematic parity) clean
    - fab outputs: Gerbers + drill zip, JLCPCB BOM/CPL, full BOM,
    interactive BOM, schematic PDF, STEP
    - BOM with live LCSC prices: $9.74/board electronics at 100 boards
    - 3D renders, generator improvements (FPC connector orientation
    solver, edge keepouts, neck widening, bundled 3D models)
2026-10-29 Make the fob smaller: 80.9 x 34.9 x 11.0 mm case, 77 x 31 x 0.8 mm board
    The 7.5 mm BS-24-B4AA016 holder set the case thickness. Replace it with
    the MYOUNG MY-2450-01 CR2450 clip (LCSC C964845, 5.70 mm, 5355 in stock,
    $0.17): a sprung plate over the cell, with a bare 12 mm ENIG pad under
    it as the negative contact. Same cell, so the battery-life budget is
    unchanged.
    - Board 80 x 34 x 1.0 -> 77 x 31 x 0.8 mm, corner radius 2.6, holes at
    the corner centres. Glass 0.9 mm from the long edges, 0.4 mm clear of
    the case's screw bosses; joystick 1.2 mm from the glass.
    - Case 83.9 x 37.9 x 13.0 -> 80.9 x 34.9 x 11.0 mm (keep-out 7.6 -> 5.8).
    - New footprint and model for the clip, drawn from dra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
2026-10-29 Check every footprint against its datasheet land pattern
    hardware/tests/footprints.yaml records the manufacturer land pattern, pin 1,
    pitch, holes and body for every footprint on the board (custom and stock
    KiCad), with the datasheet URL, page/figure and per-dimension tolerances.
    test_footprints.py checks the footprints embedded in irl2fa.kicad_pcb and
    their library copies against it, fails on any board footprint without an
    entry, and checks symbol pins against pads, the MCU against pins.yaml (EP on
    GND) and J1 against the e-paper's FPC pinout.
    No footprint error found. Stock IPC-7351 pads that are larger than the
    manufacturer's pattern (QFN-32, RV-3032 SON-8, SOT-23, SOD-123, passives)
    are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
2026-10-29 Firmware verification pack: power cuts, fuzzing, constant time, coverage, lint
    - test_powercut.c: cut the power after every flash operation of every store
    write path (add, rename, delete, settings, set/change/remove PIN, wipe,
    PIN attempts, PIN-log compaction, the wipe after ten failures), each cut
    dropped, half done or leaving noise; the rebooted store must be exactly
    the old or the new state and still usable. vhal gains cut modes and an
    operation counter.
    - Fixes found by it: PIN-log compaction now goes through the page journal
    (a cut between erase and rewrite reset the wrong-PIN count); mount
    finishes a wipe whose tenth failure was logged before the cut; torn log
    entries n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
2026-10-29 Footprint table: MYOUNG MY-2450-01 clip replaces the BS-24-B4AA016 holder
    Entry from drawing MY-CP-0106 rev A/0 (LCSC C964845): pads 6.15 x 6.00,
    outer span 36.80, 9.20 from the closed end, plate 25.50 x 23.20. The check
    now accepts pad 1 made of several pads (the clip's two + legs) and a body
    outline with rounded sides (body.curved), both opt-in per entry.
2026-10-29 Measure the power profile in Renode; make the simulator behave like the hardware
    Power, measured instead of assumed:
    - firmware/renode/models/PowerMonitor.cs observes the emulated board:
    Stop 2 entries and time (WFI with SLEEPDEEP), instructions executed,
    e-paper supply/BUSY periods by kind and SPI bytes, RTC I2C transactions,
    IR receiver on-time and every IR byte (LED-lit bits). The SSD1680 and
    RV-3032 models report their activity to it.
    - firmware/renode/power.robot runs the release firmware through a pairing
    and a scripted use (wake, contact words, codes, paging, idle to Stop 2)
    and saves JSON timelines.
    - hardware/power/model.json now holds datasheet constants only (with
    so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
2026-10-29 Add a Tamarin model of the IR pairing protocol, proved in CI
    formal/pairing.spthy models pairing.c (commit/reveal X25519, addressed
    REVEAL, HKDF key and SAS, low/high roles) against a Dolev-Yao attacker on
    the IR link, with the 6-symbol SAS compared over an authentic channel and
    SAS collisions modelled as an explicit attacker win. It proves key
    secrecy, injective agreement, that a MITM needs a SAS collision or a
    compromised device, and that each device locks the attacker's commitment
    before its own key is revealed (the basis of the 1/15625 argument in
    docs/formal-verification.md). Three broken variants (no commitment check,
    reveal before commit, no SAS comparison) must be caught.
    formal/run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
2026-10-29 Simulator at the 77 x 31 mm board size; measured battery life in the docs
    Draws the device to the smaller board's geometry (hardware/board.yaml:
    display, joystick and IR window positions), retakes the screenshots, and
    replaces the old 3.7 / 2.1 year figures in the README, release notes,
    hardware options and design review with the measured 2.2 / 1.3 years.
2026-10-29 Pairing: give up a stalled reveal after 15 s, and say so on the SAS screen
    The Tamarin model showed that a man in the middle who has finished with one
    device knows both SAS values, and can hold back his REVEAL to the other when
    they differ. That device waited on "Exchanging keys..." forever, so the
    attempt looked like an IR glitch rather than a failed pairing. REVEALING now
    times out 15 s after the peer's COMMIT (pairing_abort -> PAIR_FAILED), and
    the SAS screen tells people to cancel on both devices if the other shows no
    symbols. Regression test test_app_pair_reveal_timeout.
2026-10-30 Firmware fixes from the emulated hardware: redraws, lost presses, pairing, clock
    Power (firmware/core/app.c):
    - A screen redraws when its content changes: words every 15 s, a code
    every 30 or 60 s, the codes list every 30 s. The countdown bar moves in
    thirds of the period with partial refreshes that never trigger a full
    one; a full refresh comes on the first content change after 5 partial
    ones. Waking is a partial refresh (the sleep screen's full refresh left
    the panel clean); the sleep screen stays full so nothing sensitive is
    left on the glass.
    - Measured in Renode: a use is 74.7 s awake with 3 full + 18 partial
    refreshes, 88 mA.s (was 77-79 s, 5-6 full + 20 partial, 113-125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
2026-10-30 Fix the silkscreen and turn the IR parts to face out through the top edge
    Silkscreen: reference designators overlapped each other, sat on pads and ran
    off the board edge, because silk_overlap, silk_over_copper and
    silk_edge_clearance were only DRC warnings. They are errors now, and a new
    gen_pcb.py --step silk places every label clear of pads, other silk, part
    bodies, the coin cell and its insertion path, the FPC slot and the edge
    (0.8 mm, 0.65 mm where that can't fit; hidden only where nothing fits: the
    display, the booster diodes and inductor, and Q5). R3/R4 moved 0.3 mm clear
    of U2's pin-1 mark, the clip's "+" moved to the contact away from C11, and
    the IR parts' pin-1 bars stop short of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
2026-10-30 Assembly review: correct the CPL for JLCPCB's footprints and back-side convention
    JLCPCB places parts from its own (EasyEDA) footprints and reads back-side
    rotations as seen from the back (180 - KiCad angle). The committed CPL used
    KiCad's angles unchanged, which would have placed BT1, D1-D3, D4, Q1, Q5 and
    U2 wrong and J1 1.25 mm off its pads, while every KiCad check passed.
    - fab.py: per-LCSC correction table (rotation, origin offset, evidence) and
    JLCPCB's bottom-side rule; CPL regenerated.
    - tests/test_assembly.py + jlc_footprints.yaml: place JLCPCB's fetched pads
    with the CPL and check each lands on ours; CPL frame vs Gerbers; paste,
    mask dams, tenting, MPN vs LCSC, JLCPCB stock;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
2026-10-30 Electrical review against datasheets, with automated checks
    Review every circuit block against manufacturers' documents (Good Display
    GDEY0213B74 and SSD1680, Hirose FH34SRJ, ST DS14463/DS14548, Micro Crystal
    RV-3032-C7, AOS, Vishay, APV, Samsung, Alps, Tag-Connect): docs/electrical-review.md.
    No would-not-work defect found. Degraded: IR detector has no daylight filter
    (IR-1, xfail test), worst-case IR range ~3 cm (IR-2), weak-cell refresh margin
    (PWR-1), Si1308EDL Vth at the top of the SSD1680 range (EPD-1).
    - test_electrical.py + electrical_ref.yaml: symbol pin names vs datasheets,
    MCU pinout and alternate functions vs DS14463 tables, EXTI collisions, FPC
    pins vs the panel reference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
2026-10-30 Mechanical review against the manufacturers' drawings
    Checks the board, our part models and the case against the Good Display,
    Alps, Hirose, MYOUNG, Vishay and Murata drawings (docs/mechanical-review.md).
    Board changes needed (not made here): the display flex is 14.3 mm wide where
    it passes the 14.0 mm slot (MECH-01, critical); tracks under the coin cell
    can hold it off its negative pad (MECH-04); a via sits in the cell's
    insertion path (MECH-05).
    Fixed in the case: the joystick cap socket now fits the real stem, a 1.95 mm
    R0.5 square with its flats parallel to the board edges, gripping its top
    1.7 mm (MECH-02; it was a 3.2 mm square at 45 deg and would not have held).
    The glass rib is ope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
2026-10-30 Firmware against the silicon: ECC NMI, stuck keys, Stop 2, RTC, SPI, RNG
    A review of the STM32U0 port against RM0503, ST's CMSIS/HAL sources and pin
    data, the SSD1680 and GDEY0213B74 documents and the RV-3032-C7 manual
    (docs/firmware-hardware-review.md). Fixes, each with a test that fails on
    the old firmware:
    - A double ECC error in the store (a write cut by a power loss, which the
    store is built to survive) raised an NMI that reset the device, and the
    store is read at every boot: an endless reset loop. Store reads are now
    armed; the NMI handler clears ECCD and the store sees a torn double-word.
    - A key held down (in a pocket) auto-repeated a panel refresh every 90 ms
    and kept the d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
2026-10-30 Review the firmware against ST's errata sheet ES0602: two fixes
    - 2.1.2: some STM32U0 parts shipped with VREFINT_CAL blank (0xFFFF), which
    made the battery reading clamp to 3.60 V on any cell. Fall back to the
    datasheet's typical 1.212 V. New Renode test (fails on the old code).
    - 2.8.2: the I2C master can raise BERR spuriously while the transfer
    continues; clear it instead of failing the RTC read.
    The other 20 entries are listed in docs/firmware-hardware-review.md with
    why they don't apply (peripheral unused, or covered by CRC/retry, or the
    existing code already follows the workaround).
2026-10-30 Simple mode: a one-way, up/down-only mode for vulnerable people
    Settings -> Simple mode turns a device into one for someone who should only
    check who is calling (docs: "vulnerable (simple) mode"). It wakes straight
    to a contact: the name large, "will say:", the HEAR word in a new 34 px
    font, the previous window's word ("Also OK"), and "If they don't say this
    word, hang up and call them back." Up/down change contact (wrapping, "2 of
    4"); left, right and a short centre press do nothing, not even a redraw.
    The SAY word is never drawn. Low battery and an unset clock are shown in
    plain words. Countdown dots follow the existing partial-refresh ticks; the
    screen has no clock, so no minute redraws.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
2026-10-30 Pours on /GND and net class patterns with the sheet path (board not yet re-routed)
2026-10-30 Fix two flaky checks in the simple-mode simulator test
    - The 10 s family-PIN hold is counted from when the core sees the press;
    a 3 s full refresh starting just then delays that, so 11 s was not always
    enough. Hold 14 s (still under the 20 s stuck-key cutoff).
    - "Own SAY word drawn nowhere" was a pixel search, which also finds the word
    inside the screen's fixed text: SAY word "will" in "Susan will say:"
    failed main's CI. Skip the search only when the word is legitimately part
    of the text on screen.
    300/300 runs of the test pass with random seeds (failed ~1 in 40 before).
2026-10-30 Make the short-range pairing test statistical instead of flaky
    Listen-before-talk cannot rule out a collision when both devices start in
    the same quiet window: over 1000 random seeds, 97.7 % had none and the worst
    had 6, so "at most 2 collisions" failed about 1 run in 460. The test now
    pairs 20 times with random seeds and checks what the design claims: every
    pairing completes without bit errors in under 6 s, and the median has no
    collision. The full simulator suite passed 200/200 runs.
2026-10-30 Apply the review fixes to the board and re-route it
    Mechanical review:
    - MECH-01: FPC slot 1.4 x 17.0 mm (y 6.3..23.3) so it covers the flex's
    14.3 mm flare; EPD footprint, board, case dims and fab outputs regenerated.
    - MECH-04: B.Cu ring under the cell's negative cap (r 6..10.5) with no
    tracks or pour except one 1.2 mm corridor straight down; the pad's GND
    spoke runs through it with the solder mask open, so it is bare like the
    pad. Pad 2 joins the pour solid. New test checks tracks and pour.
    - MECH-05: no vias in the cell's insertion path (x 25.9..51.1 to the
    bottom edge); cell via keep-out r 12.6.
    - MECH-09: board.yaml carries the keytop stem data; the .scad reads it.
    Electrica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
2026-10-30 Mark the review findings fixed in 2b8301f
    Assembly A-07, A-08, A-10, A-12; mechanical MECH-01, -04, -05, -09;
    electrical IR-1, IR-2, EPD-1, C-1, C-2, C-5. C-3 and C-6 (both optional)
    are left as they are, with the reason.
2026-10-30 Signed firmware updates over IR
    A bootloader that installs only firmware signed with the IRL2FA release key,
    received over the IR link from another IRL2FA or from a computer with a
    ~$5 USB-UART infrared adapter. The record store is never touched: codes,
    contacts and settings survive every update. No USB or radio added.
    docs/firmware-updates.md has the user steps, the adapter, the security
    model, the formats and the tests.
    Flash (STM32U083KC, 2 KB pages): bootloader 26 KB | application slot 96 KB
    | staging slot 50 KB | journal 4 KB | record store 80 KB (unchanged).
    The 16 KB target for the bootloader was not met: 24.5 KB, of which
    Monocypher's Ed25519 check is about 13 KB.
    - Image: 128-byte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
2026-10-30 Lock the debug port only from Settings; fail the build when the flash is full
    Readout protection (RDP level 1) is never set automatically any more: not
    at a power-on, not when the owner first wakes the device. The owner sets
    it with Settings -> Lock debug port:
    - behind the device PIN (asked again; a wrong one counts and locks the
    device), and in simple mode only through the family-PIN path, like
    every setting;
    - a screen in plain words (stops someone with the device and a debug
    cable from reading its codes; permanent, undoing it erases everything;
    updates over IR still work), then a confirm;
    - then the existing mailbox path: the bootloader locks only for a signed
    application on a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
2026-10-30 Release v0.2.0: version bump, board revision mark, release notes
    - IRL2FA_VERSION 0.2.0; silkscreen "v0.2 irl2fa.com"; fab outputs, renders
    and screen images regenerated.
    - gen_pcb.py --step silk: a marking whose wording changed is reused for the
    new text (pcbnew can't remove it from Python), and the list of unwanted
    texts is built before the test-pad labels are placed, so a fresh board
    build no longer hits an undefined name.
    - Release notes for v0.2.0.
2026-10-31 Cap the PCB build containers' memory
    Uncapped, each Freerouting JVM sized its heap to a quarter of the host
    (11.8 GB on home-server). Six worktrees routing at once on 2026-10-30
    took MemAvailable from 18 GB to 2.8 GB in two minutes and froze the
    server. Freerouting now runs in 3 GB (heap 75% of it) and KiCad in 4 GB,
    with swap capped to the same, both overridable via ROUTE_MEM/KICAD_MEM.
    A 5-pass route peaked at 310 MB of heap under the cap.
