gemivnet/IRL2FA/(notices)

Notices in the files:
README.md:
License: AGPL-3.0 | CERN-OHL-S-2.0 | CC-BY-SA-4.0
hardware/irl2fa.kicad_sch:
Licence: CERN-OHL-S-2.0
